aikos-home/intercom/hardware/v3/images/bild_v3_lautsprecher_explosion.png

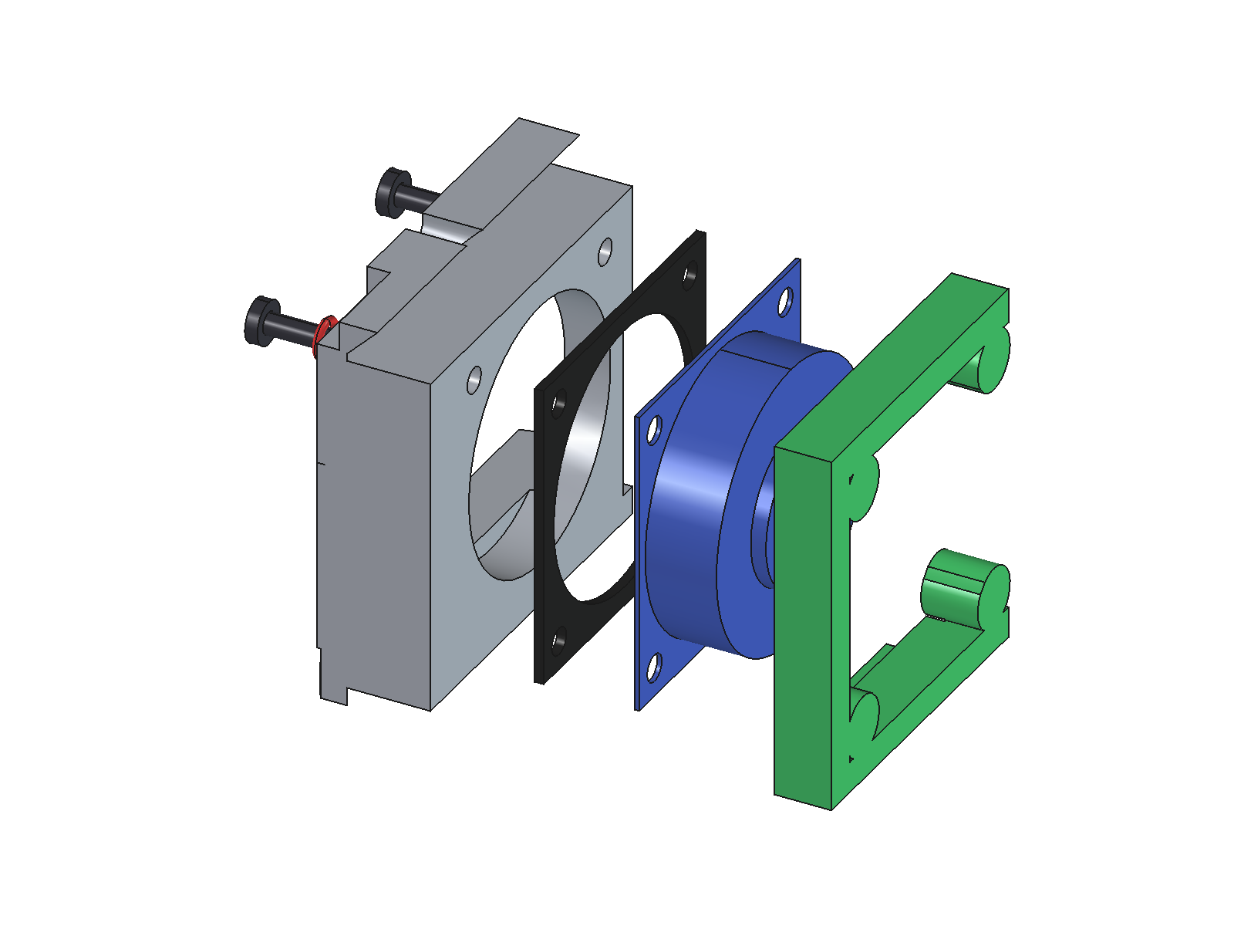
hardware/v3/images/bild_v3_lautsprecher_explosion.png
