aikos-home/intercom/hardware/v3/images/bild_v3_lautsprecher_schnitt.png

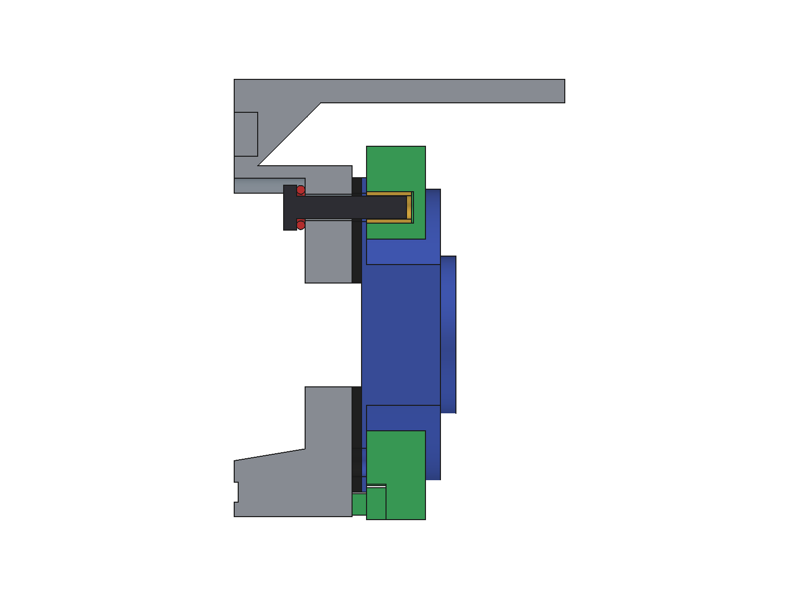
hardware/v3/images/bild_v3_lautsprecher_schnitt.png
