aikos-home/intercom/hardware/v3/images/bild_v3_radar_kleben.png

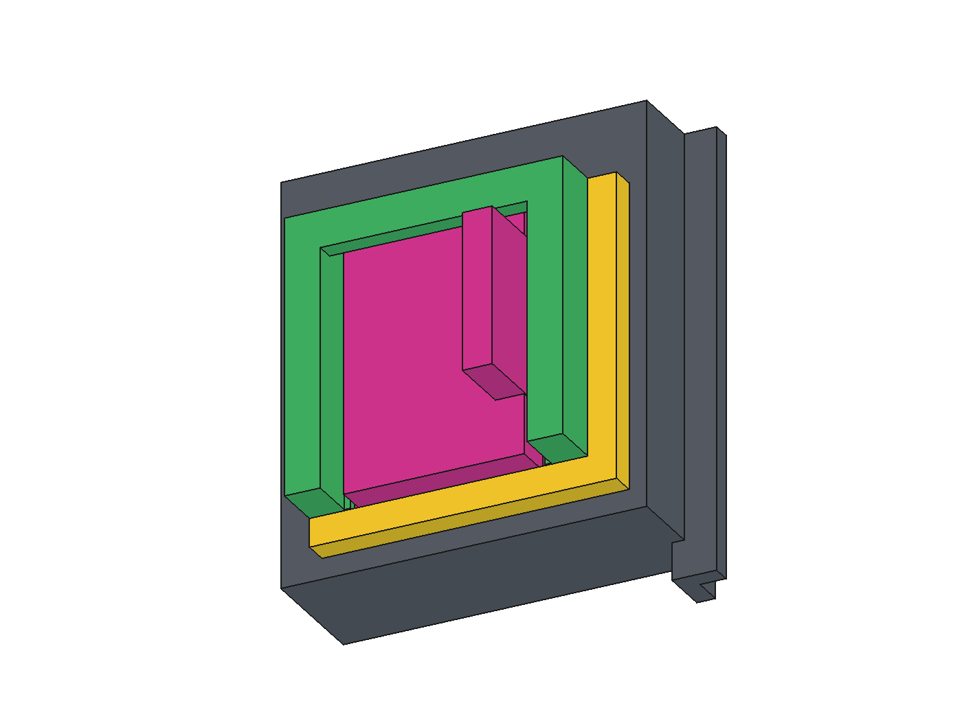
hardware/v3/images/bild_v3_radar_kleben.png
