aikos-home/intercom/hardware/v3/images/bild_v3_traeger_rueckseite.png

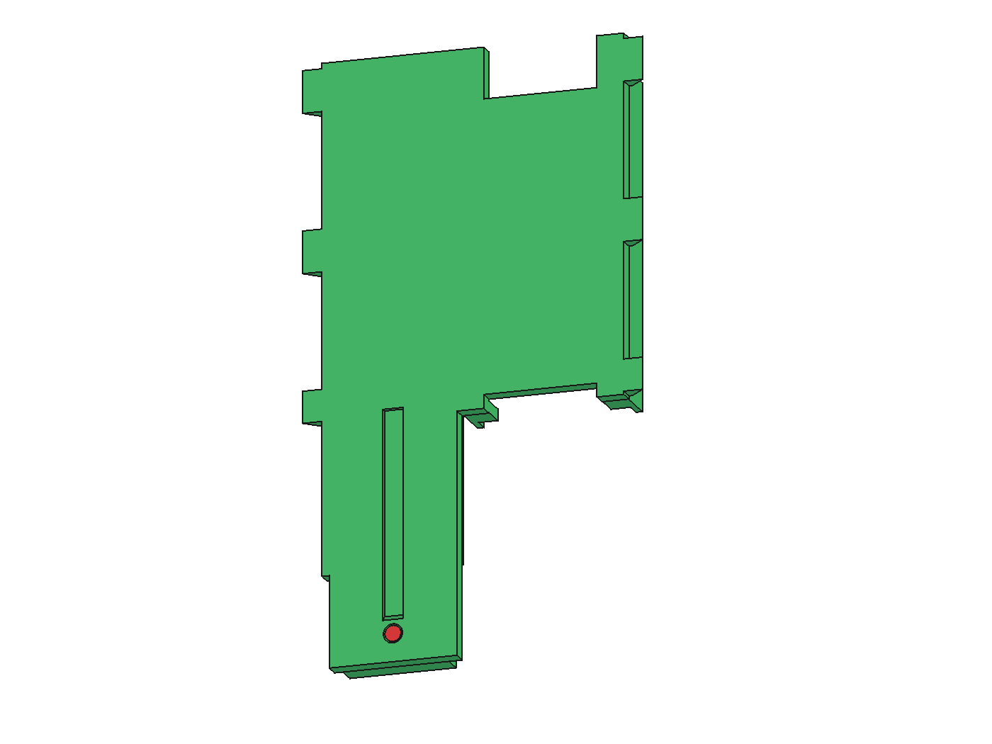
hardware/v3/images/bild_v3_traeger_rueckseite.png
