aikos-home/intercom/hardware/v3/metal/stahlblech_v3_kontur.dxf

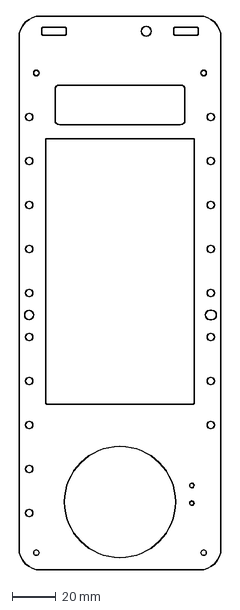
[picture p7: CAD file, 2026-10-20]
hardware/v3/metal/stahlblech_v3_kontur.dxf
91.8 x 251.8 mm
