aikos-home/intercom/hardware/v3/print/15_messing_ersatz_oben.stl

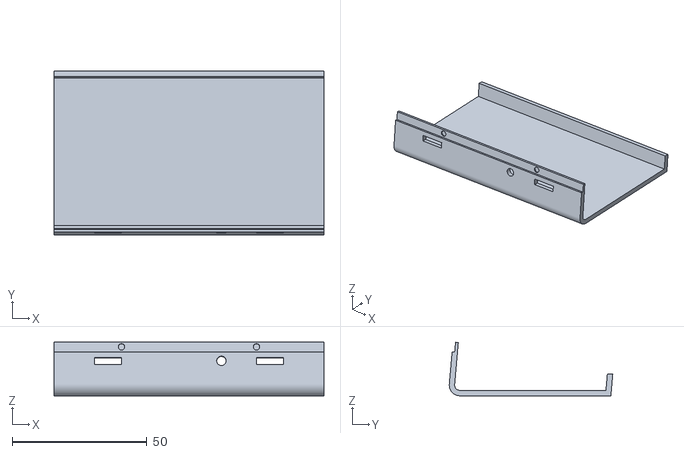
[picture p8: CAD file, 2026-10-20]
hardware/v3/print/15_messing_ersatz_oben.stl
100.0 x 60.6 x 19.8
