aikos-home/intercom/hardware/v3/metal/messing_v3.step

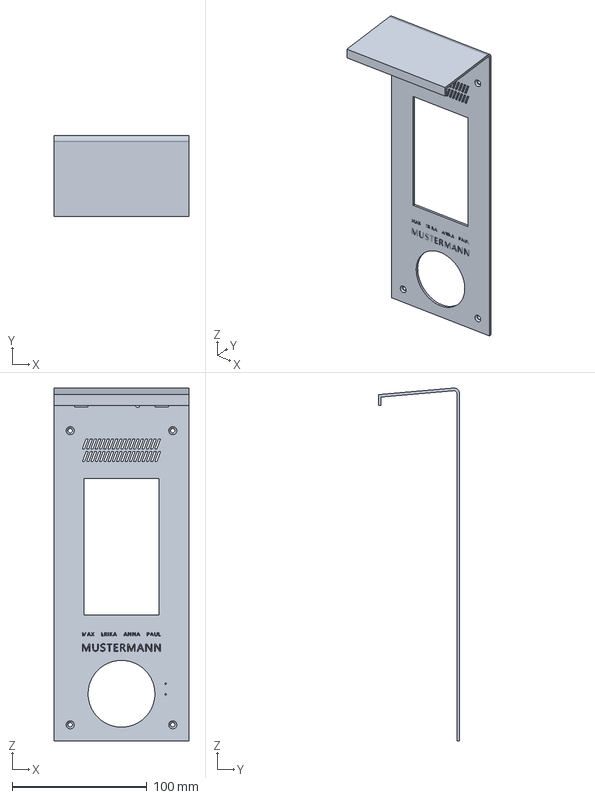
[picture p9: CAD file, 2026-10-20]
hardware/v3/metal/messing_v3.step
100.0 x 60.0 x 261.6 mm
