aikos-home/intercom/hardware/v3/print/05_radar_rahmen.stl

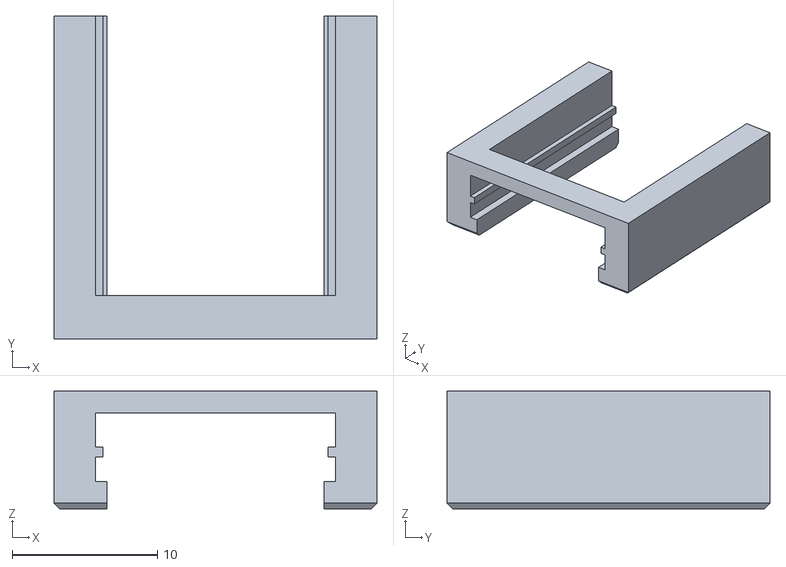
[picture p10: CAD file, 2026-10-20]
hardware/v3/print/05_radar_rahmen.stl
22.3 x 22.3 x 8.11
