aikos-home/intercom/hardware/v3/print/18_display_abstandsstuecke_3_staerken.stl

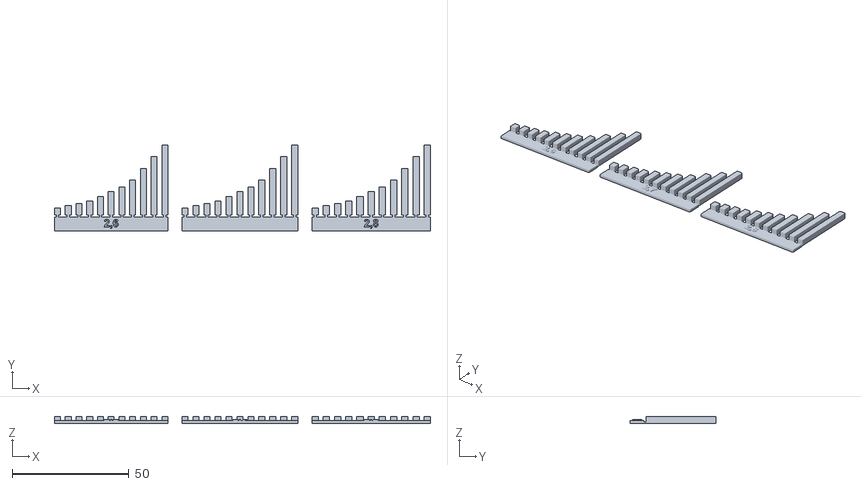
[picture p11: CAD file, 2026-10-20]
hardware/v3/print/18_display_abstandsstuecke_3_staerken.stl
161.1 x 36.8 x 3.00
