aikos-home/intercom/hardware/v3/print/01_kasten.stl

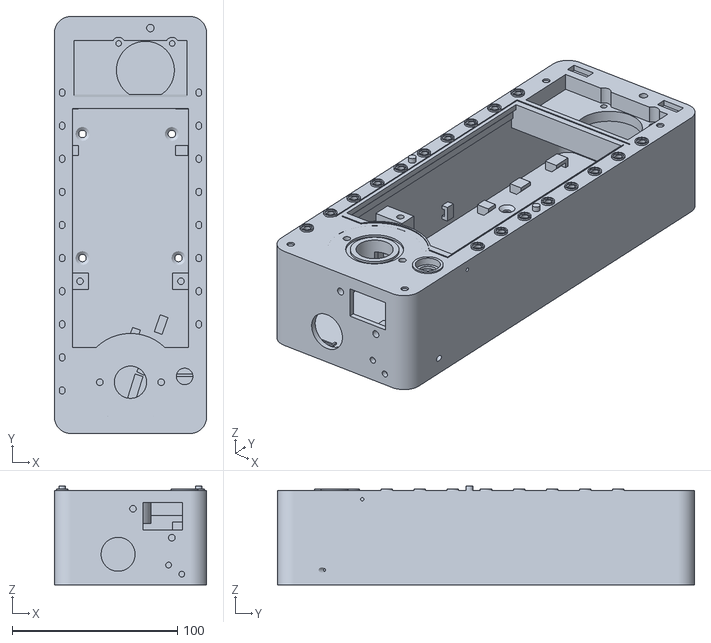
[picture p12: CAD file, 2026-10-20]
hardware/v3/print/01_kasten.stl
92.0 x 252.0 x 59.7
