aikos-home/intercom/hardware/v3/print/10_gegenleisten_ersatz_fuer_druckpause.stl

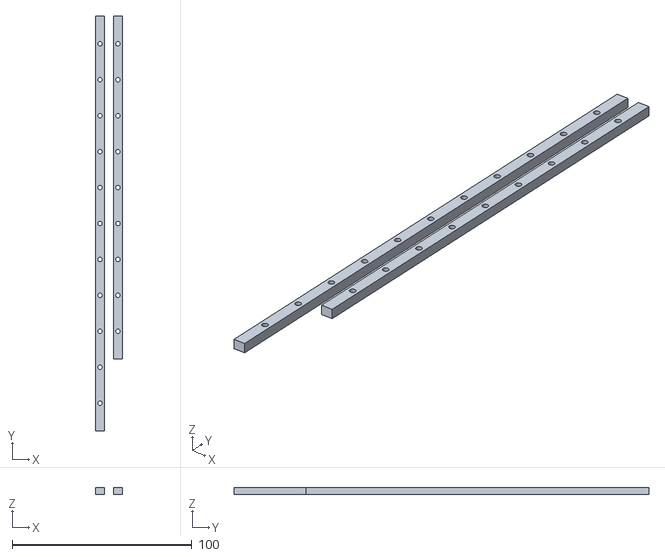
[picture p13: CAD file, 2026-10-20]
hardware/v3/print/10_gegenleisten_ersatz_fuer_druckpause.stl
15.0 x 231.0 x 4.00
