aikos-home/intercom/hardware/v3/print/03_computer_traeger.stl

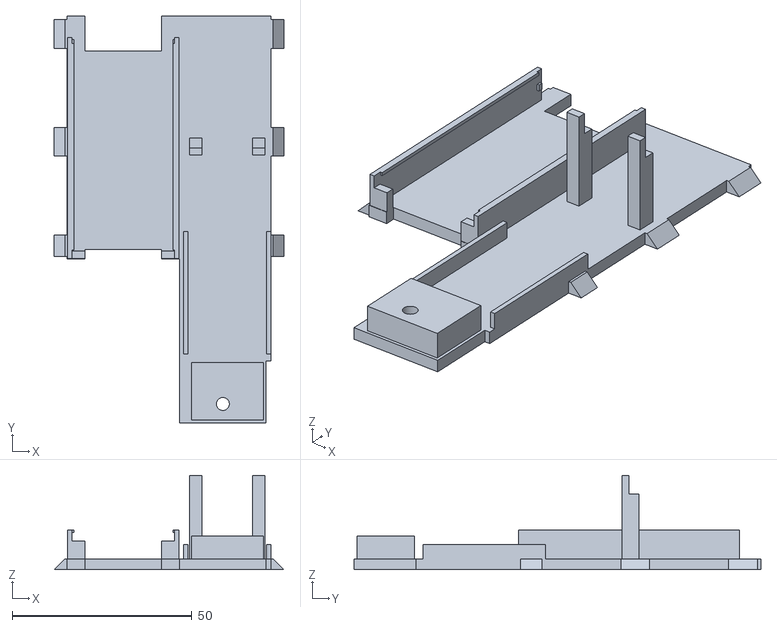
[picture p14: CAD file, 2026-10-20]
hardware/v3/print/03_computer_traeger.stl
64.0 x 113.3 x 26.3
