aikos-home/intercom/hardware/v3/print/04_lautsprecher_klemmring.stl

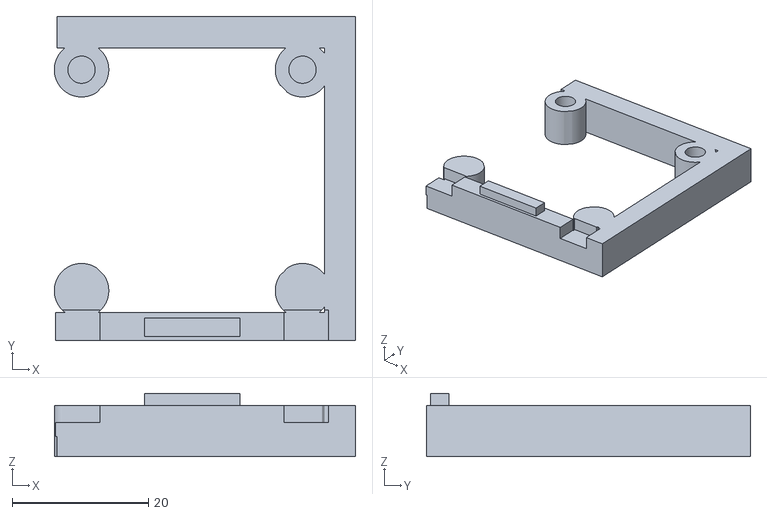
[picture p15: CAD file, 2026-10-20]
hardware/v3/print/04_lautsprecher_klemmring.stl
44.2 x 47.5 x 9.30
