aikos-home/intercom/firmware/setup/setup-preview.png

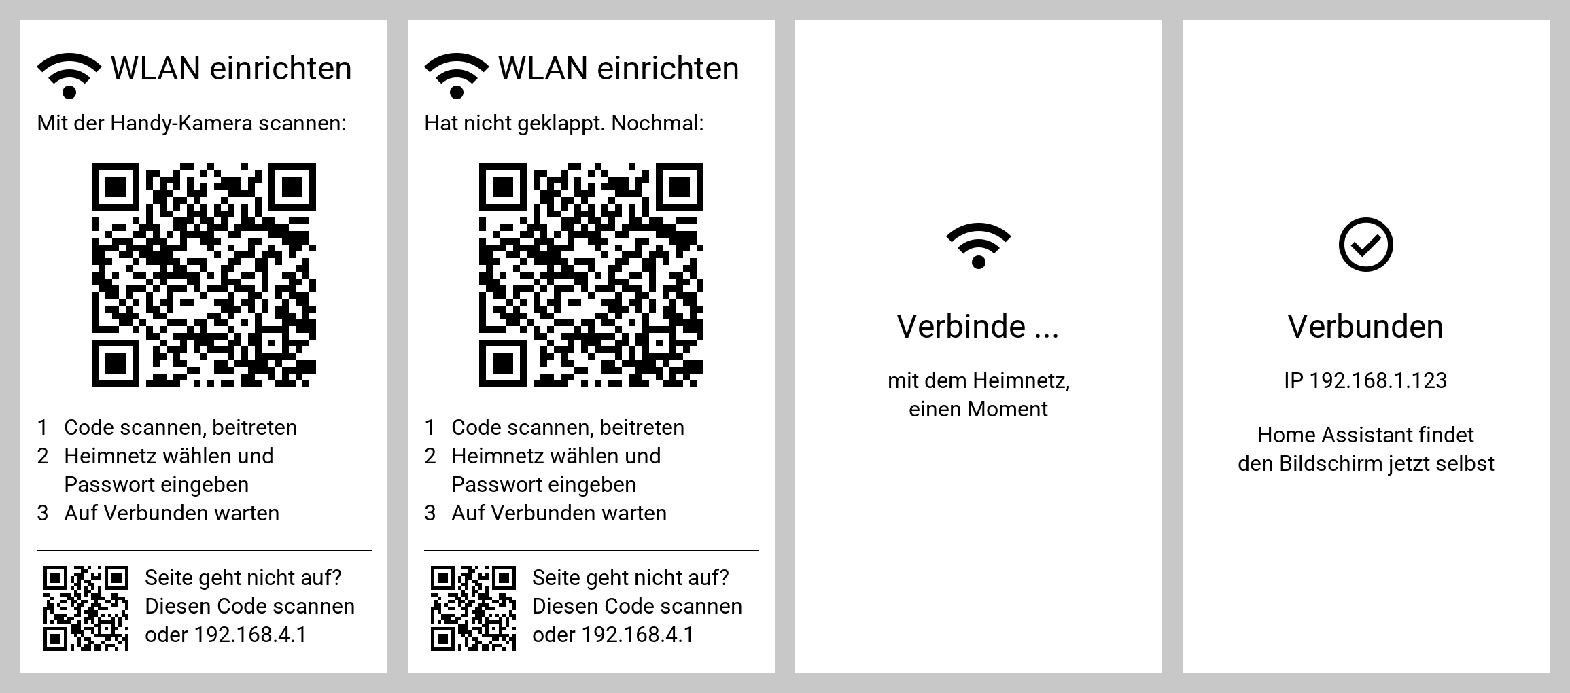
firmware/setup/setup-preview.png
