aikos-home/intercom/(commit log)

2026-09-29 Screen touch chip settled: GT911 at 0x5D
    An I2C scan on the arrived LilyGO T5-4.7-S3 Touch found the GT911 (product
    id "911") and the PCF8563 clock chip, not the L58, so ESPHome's gt911 driver
    applies. Adds the scan script, a build-log entry, and updates the explorer,
    BOM and open points.
2026-09-29 Measure the LilyGO display: holes, glass, visible area, folded stack
    LilyGO publishes none of these. One V2.4 unit measured with a caliper:
    seven Ø3.94 mounting holes, touch glass 120.1 x 66.77, visible area
    56.95 x 101.9, and an 11.9 mm stack once the loose screen is folded onto
    the board. Adds the numbers as a parts page, a build-log entry and the
    explorer update.
2026-09-29 Screen firmware: flash-free fast e-paper refresh
    ESPHome firmware for the LilyGO T5-4.7-S3 screen with a modified copy of
    the hbast/lilygo_t5_47_plus driver (GPLv3, upstream licence kept). Instead
    of wiping the panel before every picture, each pixel is moved by exactly
    the frames between its old and new grey level, all changed rows in one
    sweep, in a background task so touch is never blocked. Thin lines next to
    lightened pixels are re-darkened. A tap now updates in about 0.5 s without
    a flash (was 2 s with a full flash).
2026-09-29 Screen: page change with a short flash, demo of what the screen can show
    The flash-free partial refresh now gets exactly the ink time of a full
    refresh, lightens pixels only by what they were darkened with (DC
    balance) and goes through white for grey changes. A true page change is
    an explicit flag and gets one short black-white flash: on the bench every
    flash-free variant left the previous page behind as a faint trace. Also
    fixes a touch-driver bug that reported a moving finger as lifted.
    Adds an eight-page demo (drawing, photos, vector graphic, icons, QR
    codes, text sizes, grey levels, animation) and the findings in
    docs/screen-ux.md.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
2026-09-30 Doorbell: bell firmware on the Waveshare ESP32-S3-ETH, WT32-ETH01 dropped
    The WT32-ETH01 always started in download mode (its Ethernet oscillator holds the
    IO0 boot pin low); pull-ups did not fix it, so the bell moved to the Waveshare
    ESP32-S3-ETH. The bell logic lives in one board-independent file.
    Bench fixes that each cost presses: API batching off (fast on/off pairs merged),
    internal pull-up so a loose wire reads as "cut", press hysteresis, 1 ms sampling.
    Includes the WT32 boot-fault probe scripts and an updated parts list.
2026-09-30 Explorer: doorbell computer is the Waveshare ESP32-S3-ETH
    The WT32-ETH01 is dropped (boot fault). Talk computer board and the power
    path (splitter or the doorbell computer's PoE module) are marked as open.
    Ring tour updated to the bench-tested line levels and 1 ms sampling.
2026-09-30 README: concept renders of the intercom and the RoomKey at the top
    The brass front as an AI-generated concept render (Google Gemini) with placeholder
    names, next to its counterpart in the rooms, the RoomKey. Both are labelled as renders,
    not photos of built devices. The render carries no metadata.
2026-10-04 Sync 2026-10-04: firmware of all three door computers, wiring of the box, self-healing
    - firmware/: bell (Wi-Fi bridge "aikos", safe firmware in the factory partition, guards), talk computer
    (voice v2 via aikos_voice, mic on GPIO1/2/6, speech capped at -6 dB, no chime at the door), screen
    (ring/call/talk pages, phantom-press fix after a bell restart); shared components; example secrets
    - firmware/WIRING.md: the bench wiring pin by pin, with how each part was checked
    - docs: architecture/BOM marked with the bench state, build log 1-4 October, links to the new layout
    - tools/privacy_scan.py: allowed phrases also cover the built-in checks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
    [partitions-bell.csv]
2026-10-04 BOM: measured sizes of microphone, amplifier and speaker; bench gain setting
2026-10-20 Firmware: bell 0.3.23 with two climate sensors, test press, 60 ms debounce; screen 0.7.14
    - bell: one I2C bus on header pins 34/31 (GPIO17/18): SHT31-D in the outdoor chamber (0x44), BME280 on the
    distribution board (0x76); written, not yet on the device
    - bell: API action test_press(hold_ms) runs the real ring path without touching the button
    - bell: a press ends only after 60 ms released (the brass contact opened for 29-48 ms inside one press)
    - screen: text only black on white or white on black; the first chat bubble of a call flashes once
2026-10-20 Wiring: the box as soldered on 16-20 October, wire by wire, with the soldering sheets
    Replaces the breadboard wiring of 4 October: distribution board (rails, button-line circuit, BME280, 16 wires),
    computer carrier (bell <-> talk computer, supervision wires), microphone, amplifier, button with its end-of-line
    resistor, climate chamber, screen and radar, and the results of the first power-on in the box.
2026-10-20 Hardware: box v3.7 with all printed parts, metal templates and the print and assembly guide
    - hardware/v3/: generators (paths made relative, outputs into cad/out/), 20 STL in print orientation, steel/brass/
    diffuser templates (not for ordering yet), renders, the full guide (German) and an English summary
    - built from these scripts on 20 Oct 2026: all checks pass, every part except the lower brass half is byte-identical
    to the files the prototype was printed from; the brass carries the placeholder engraving
    - the September in-wall box moves to hardware/archive/; its scripts no longer carry absolute paths
2026-10-20 Docs: state of 20 October: the prototype runs in its v3 box
    README (EN/DE), architecture (power over the PoE module, two climate sensors, talk with the room keys and
    transcripts, the v3 box), bill of materials for the box as built, build log 4-20 October, the fixed black/white
    rule for the door screen.
2026-10-20 Explorer: the as-built system; roadmap regenerated
    No splitter, no 12 V path, no pressure vent; the PoE module feeds the box; new: distribution board, outdoor sensor,
    radar, room keys, supervision wires, direct ring path, voice link and transcripts. Talk tour now describes the real
    call; winter tour marked planned; milestones and open points brought up to date.
2026-10-20 Firmware: door features wired (screen 0.7.15, talk 0.7.21, bell 0.3.23), not yet on the devices
    - Screen: 'Bei jemandem klingeln' fires the Home Assistant event esphome.aikos_door_ring {target, source} (it only
    showed the ring page before); 'Nachricht hinterlassen' opens the door microphone through the talk computer and shows
    the recognised words (it was a placeholder); quiet hours from the aikos integration; presence radar HLK-LD2410C on
    the screen's RX/TX holes (UART0 is free: the screen logs over USB), frozen during calls.
    - Talk computer: the bell's press counter straight from the bell again (a key that holds within 2 minutes answers that
    ring, without Home Assistant); the screen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
2026-10-20 Docs and explorer: radar and dew point are written firmware now; bell README: climate sensors, test press, debounce
    The radar runs on the screen's GPIO43/44 (the screen logs over USB, so no log move is needed); climate sensors with
    the box's dew point in bell 0.3.23. Both written, not yet on the devices. The bell README additions were lost in an
    earlier sync and are back, now from the firmware source.
2026-10-20 Firmware: heartbeat sensors for the supervision wires (bell 0.3.24, talk 0.7.22); screen 0.7.16 ignores the radar in its first minute
    All three flashed and confirmed on 20 Oct 2026; both heartbeats arrive.
2026-10-21 Bell 0.3.25 / talk 0.7.25: test reset over the supervision wires (both proven in the box)
2026-10-21 Bell 0.3.26: heater governor for the e-paper foil (dew point margin, minimum temperature, max power; off by default)
2026-10-21 Bell 0.3.27: door light (SK6812 RGBW strip); the heater pauses while it is on
2026-10-21 Bell 0.3.28: door light 10 LEDs, capped at 75 % until the full-load test; wiring of light and heater in WIRING.md
2026-10-21 Bell 0.3.29 heater test power; READMEs brought up to screen 0.7.21, bell 0.3.29, talk 0.7.25
2026-10-21 Screen 0.7.22: radar minimum distance and confirm time filters (off by default)
2026-10-21 Screen 0.7.23: photo the right way round, bell hint below the tiles, new welcome layout, answer button fits
2026-10-22 Screen 0.7.31: HA binary sensors trigger on their first state, so a mute set before a restart counts
